jingyitang826/rfid-cocktail-bot/Input/Images/Input_Breadbord_Wiring.jpg

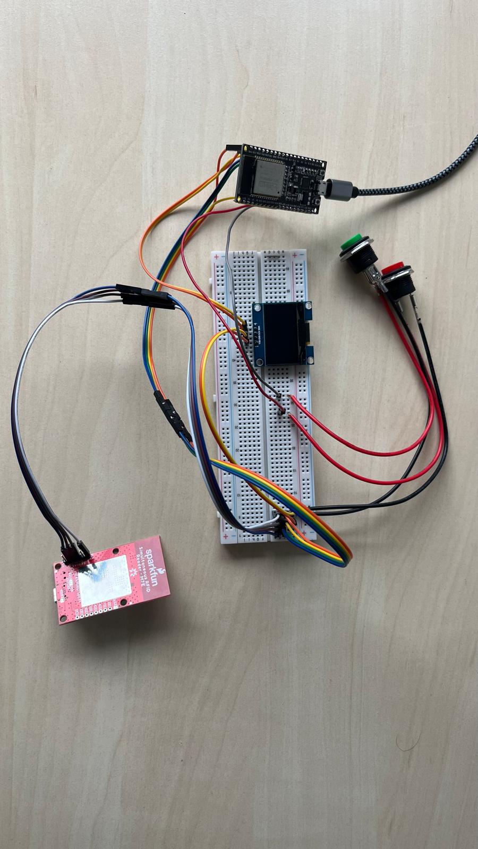
Input/Images/Input_Breadbord_Wiring.jpg
