jingyitang826/rfid-cocktail-bot/Input/Images/RFID_Wiring.jpg

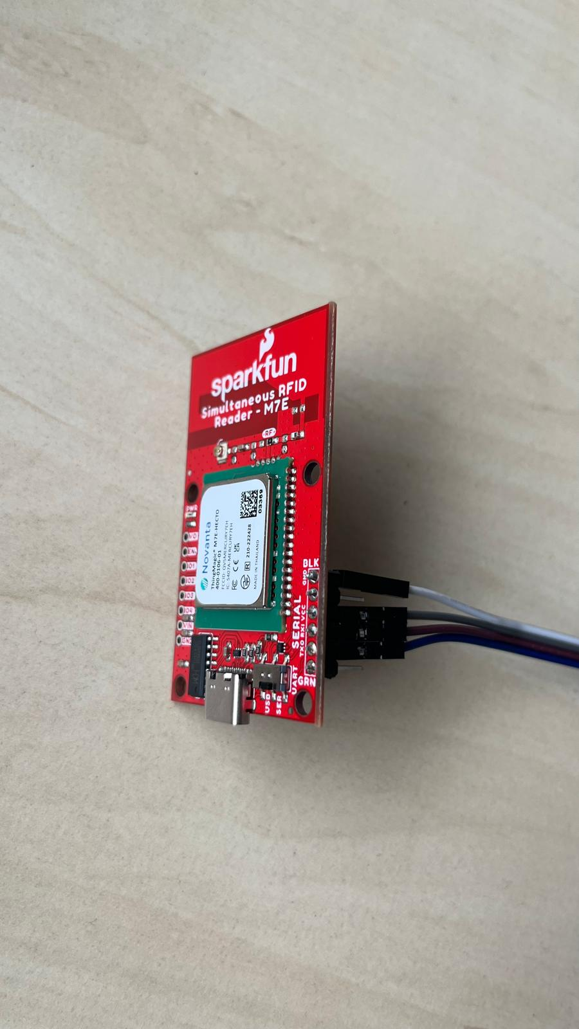
Input/Images/RFID_Wiring.jpg
