jingyitang826/rfid-cocktail-bot/Input/Images/Input.jpg

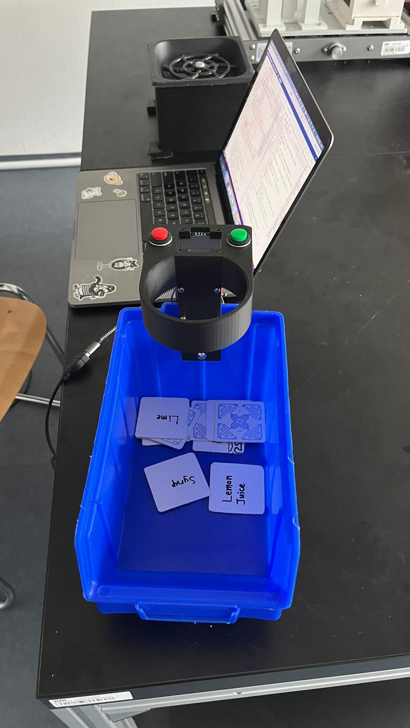
Input/Images/Input.jpg
