jingyitang826/rfid-cocktail-bot/Input/Images/Input_Back_View.jpg

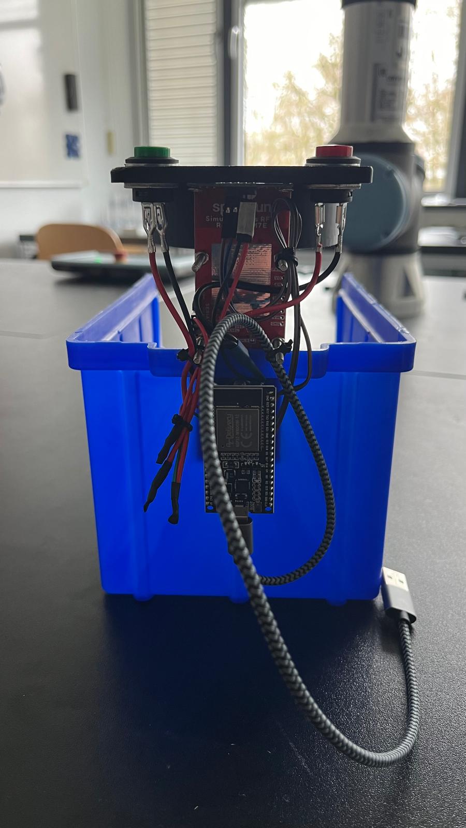
Input/Images/Input_Back_View.jpg
