jingyitang826/rfid-cocktail-bot/Input/Images/Input_Basket_Bottom.jpg

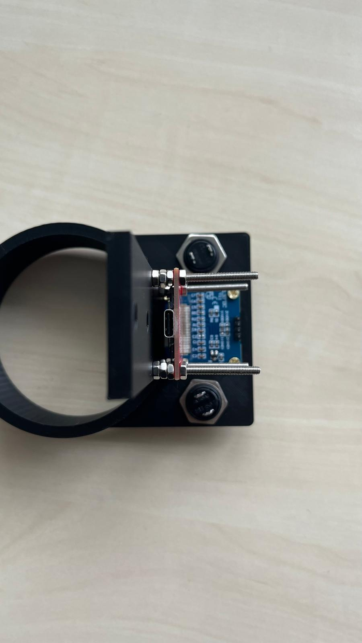
Input/Images/Input_Basket_Bottom.jpg
