jingyitang826/rfid-cocktail-bot/Input/Images/Input_Basket_Side.jpg

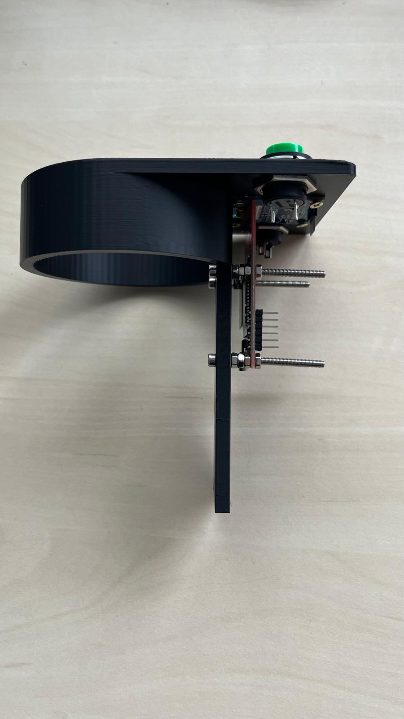
Input/Images/Input_Basket_Side.jpg
