jingyitang826/rfid-cocktail-bot/Input/Images/Input_Mount_1.jpg

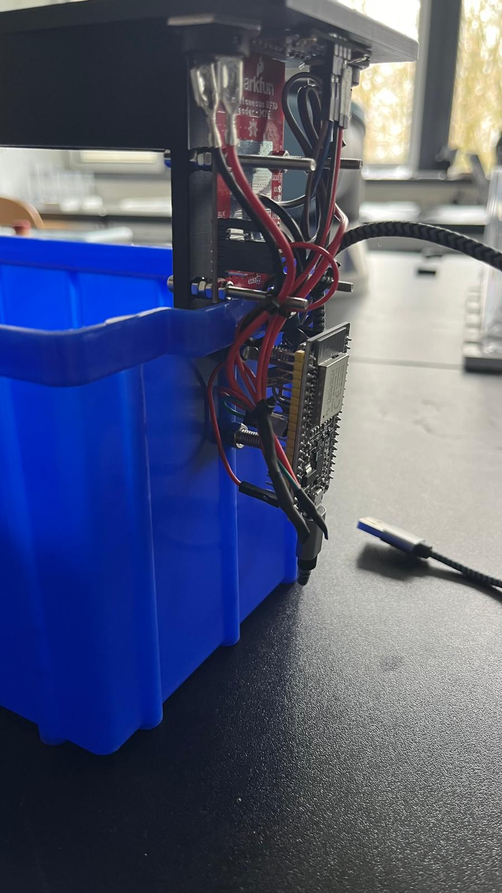
Input/Images/Input_Mount_1.jpg
