jingyitang826/rfid-cocktail-bot/Input/Images/Input_Mount_2.jpg

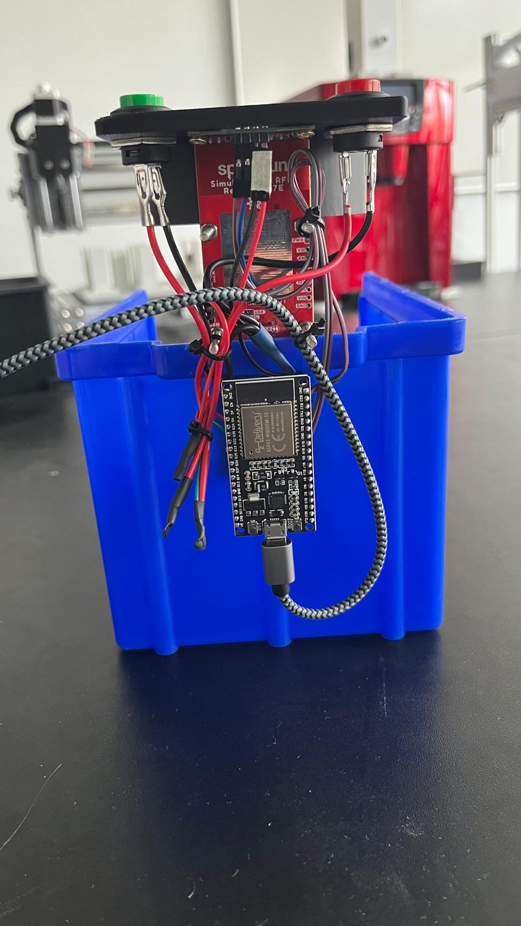
Input/Images/Input_Mount_2.jpg
