jingyitang826/rfid-cocktail-bot/Input/Images/Input_Mount_3.jpg

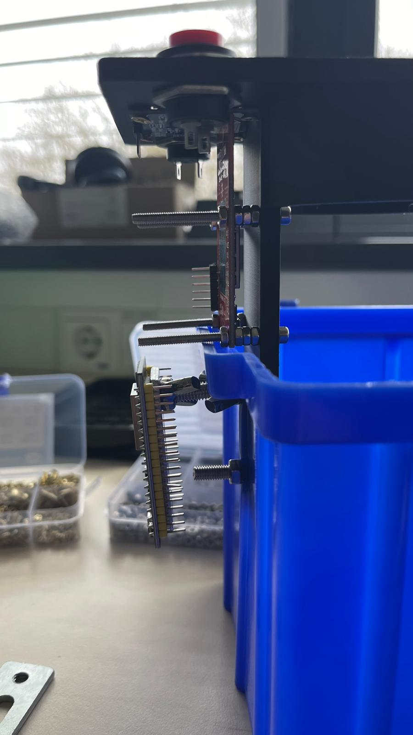
Input/Images/Input_Mount_3.jpg
