jingyitang826/rfid-cocktail-bot/Input/Images/Input_Mount_4.jpg

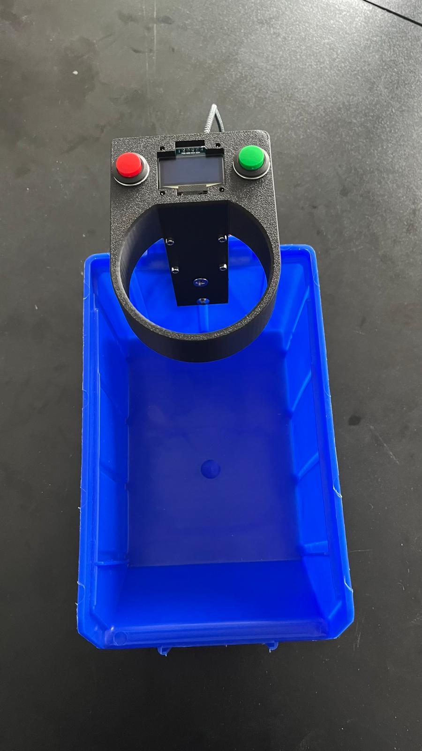
Input/Images/Input_Mount_4.jpg
