jingyitang826/rfid-cocktail-bot/Input/Images/Input_Mount_5.jpg

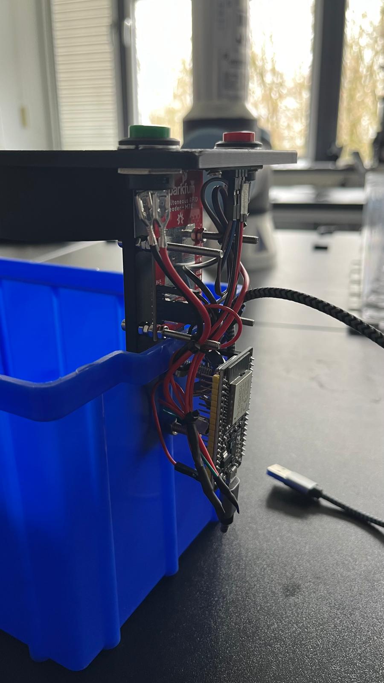
Input/Images/Input_Mount_5.jpg
