jingyitang826/rfid-cocktail-bot/Input/Images/Input_Top_View.jpg

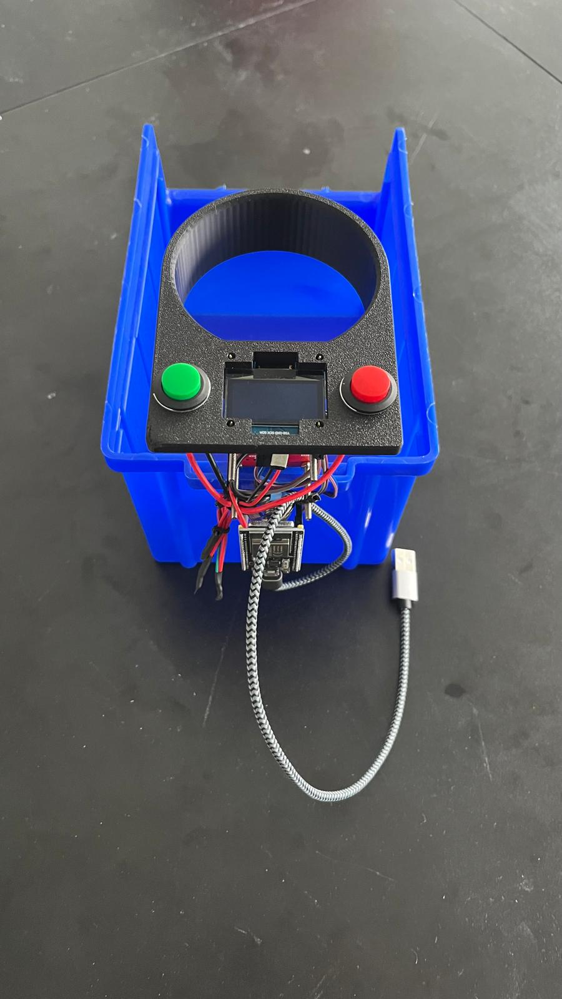
Input/Images/Input_Top_View.jpg
