jingyitang826/rfid-cocktail-bot/Input/Images/Input_with_RFID_Chips.jpg

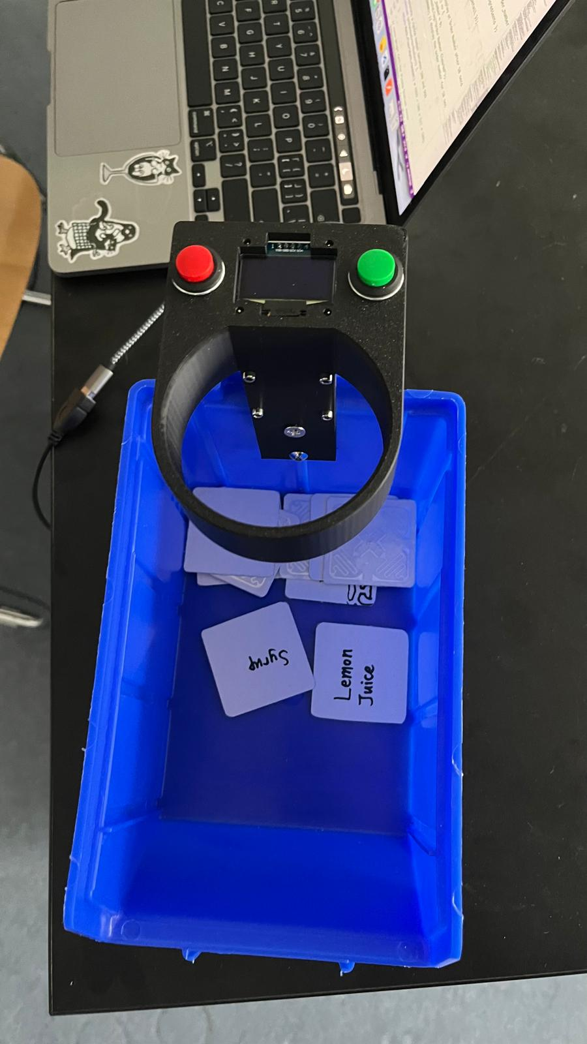
Input/Images/Input_with_RFID_Chips.jpg
