jingyitang826/rfid-cocktail-bot/Input/Images/RFID_and_ESP32_Mounted_2.jpg

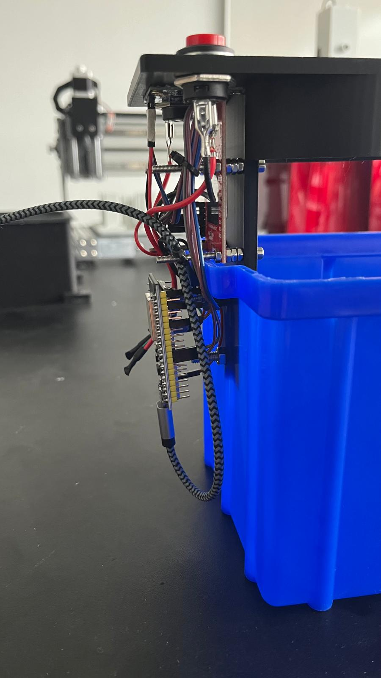
Input/Images/RFID_and_ESP32_Mounted_2.jpg
