jingyitang826/rfid-cocktail-bot/Videos/Cocktail_Robot.jpg

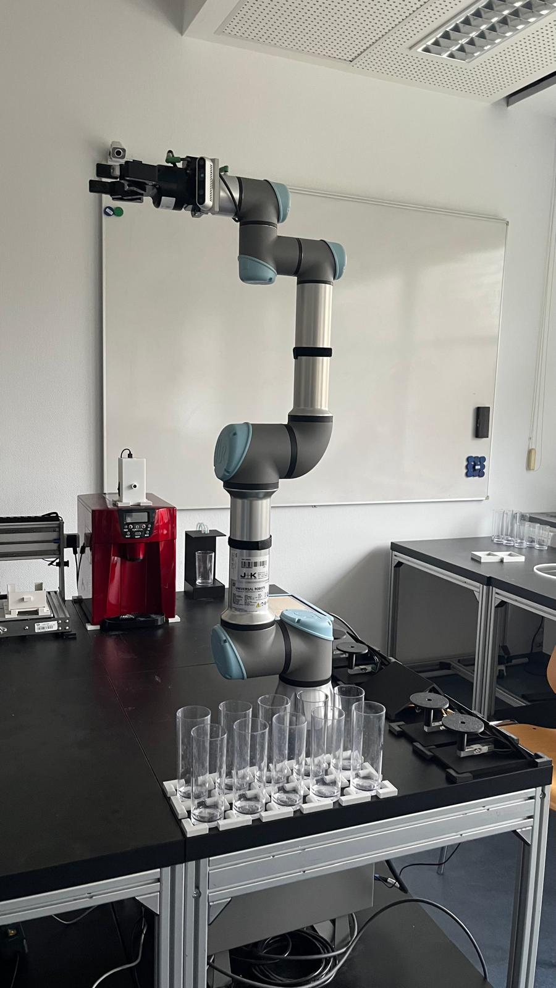
Videos/Cocktail_Robot.jpg
