jingyitang826/rfid-cocktail-bot/Input/Input_Basket.3mf

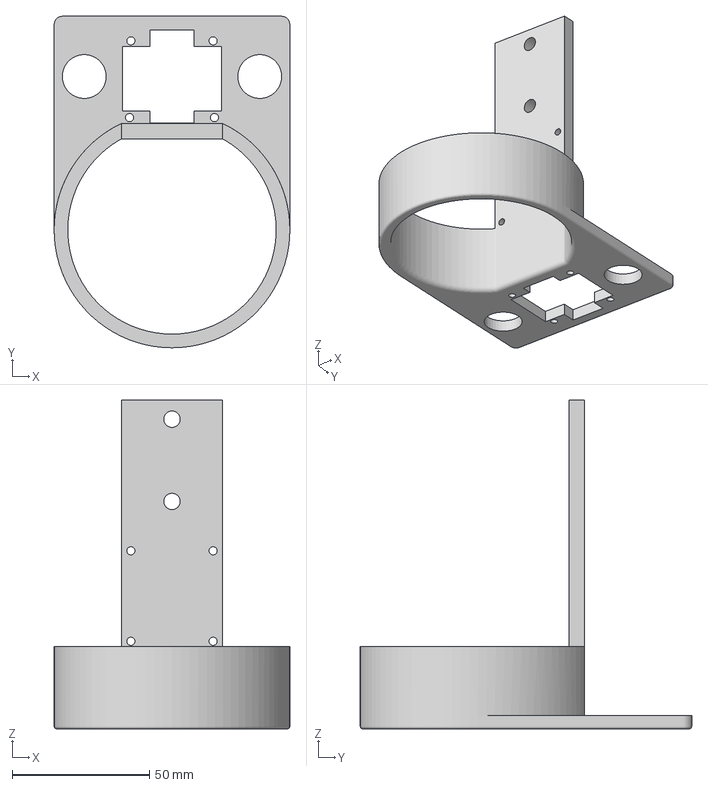
[picture p17: CAD file, 2025-04-29]
Input/Input_Basket.3mf
86.0 x 120.9 x 120.0 mm
