jingyitang826/rfid-cocktail-bot/Output/Output_Weight_Cell_Tray.stl

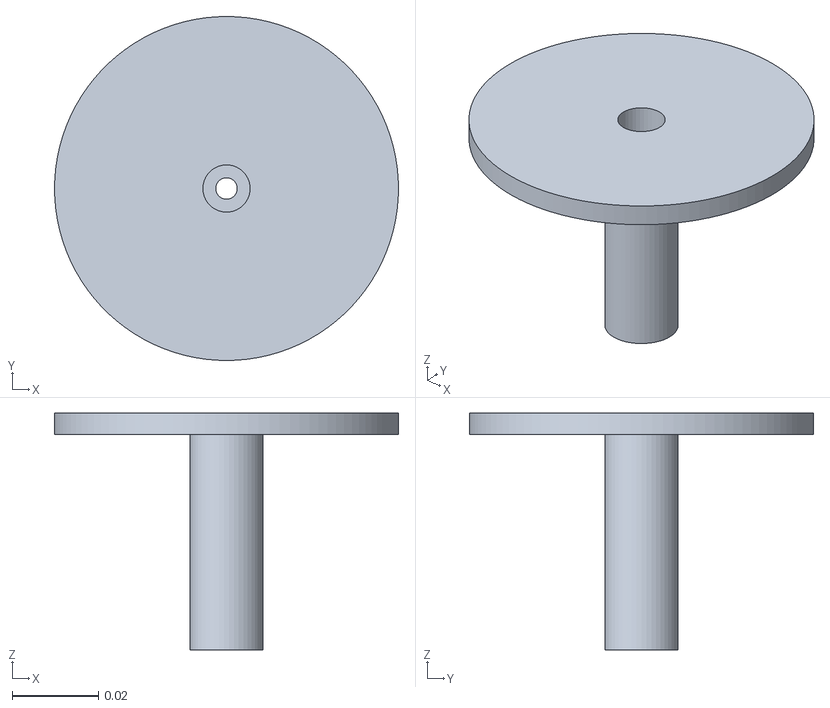
[picture p18: CAD file, 2025-04-30]
Output/Output_Weight_Cell_Tray.stl
0.08 x 0.08 x 0.055
