jingyitang826/rfid-cocktail-bot/Output/Output_Screen_Mount.3mf

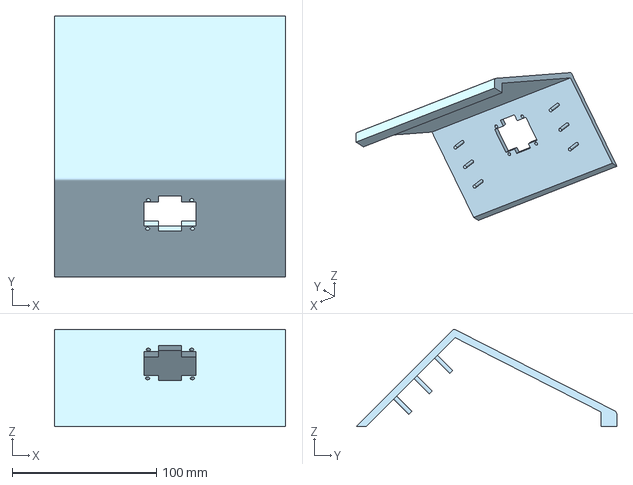
[picture p19: CAD file, 2025-04-30]
Output/Output_Screen_Mount.3mf
160.0 x 180.8 x 67.2 mm
