jingyitang826/rfid-cocktail-bot/Output/Output_Weight_Cell_Lower_Part.stl

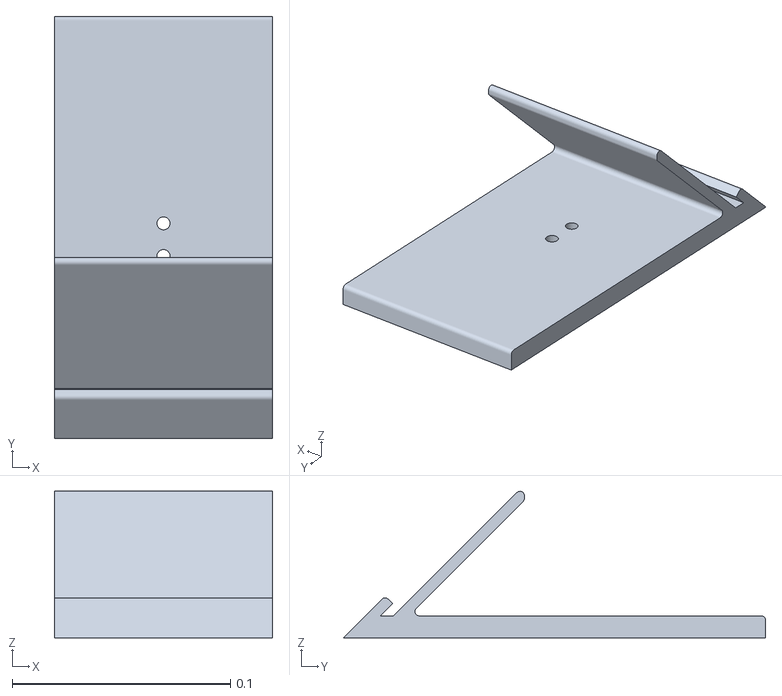
[picture p20: CAD file, 2025-04-30]
Output/Output_Weight_Cell_Lower_Part.stl
0.1 x 0.194 x 0.0672
