jingyitang826/rfid-cocktail-bot/Output/Output_Weight_Cell_Spacer.stl

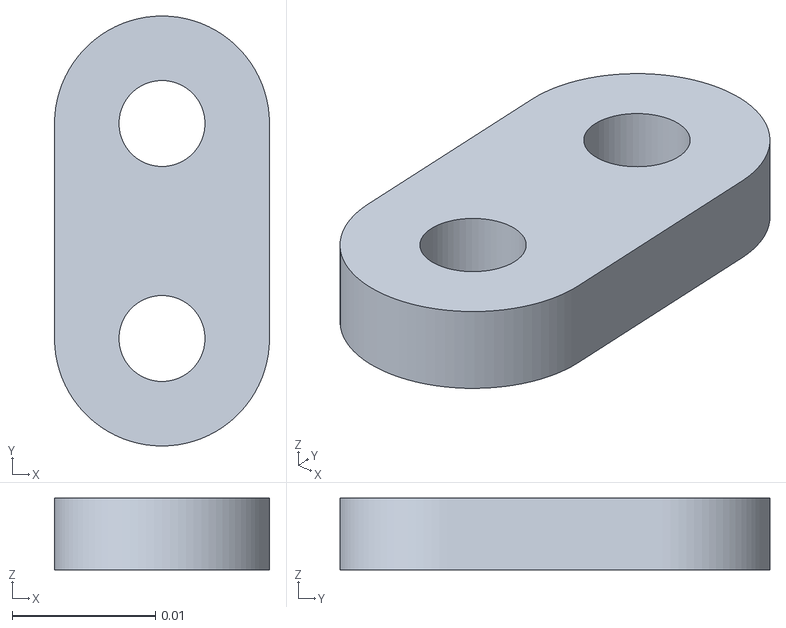
[picture p21: CAD file, 2025-04-30]
Output/Output_Weight_Cell_Spacer.stl
0.015 x 0.03 x 0.005
