jingyitang826/rfid-cocktail-bot/Input/Images/RFID_Assembly.jpg

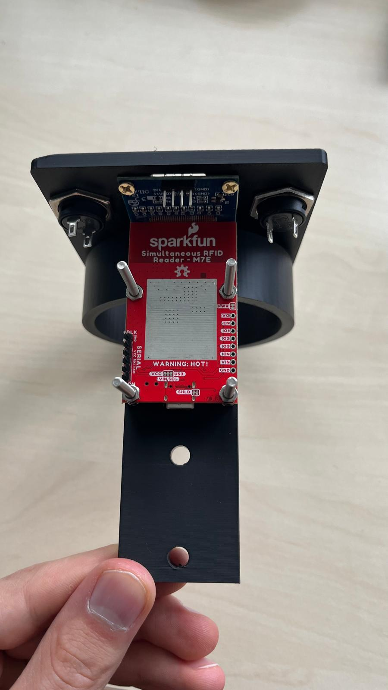
Input/Images/RFID_Assembly.jpg
