jingyitang826/rfid-cocktail-bot/Input/Images/RFID_Assembly_Side.jpg

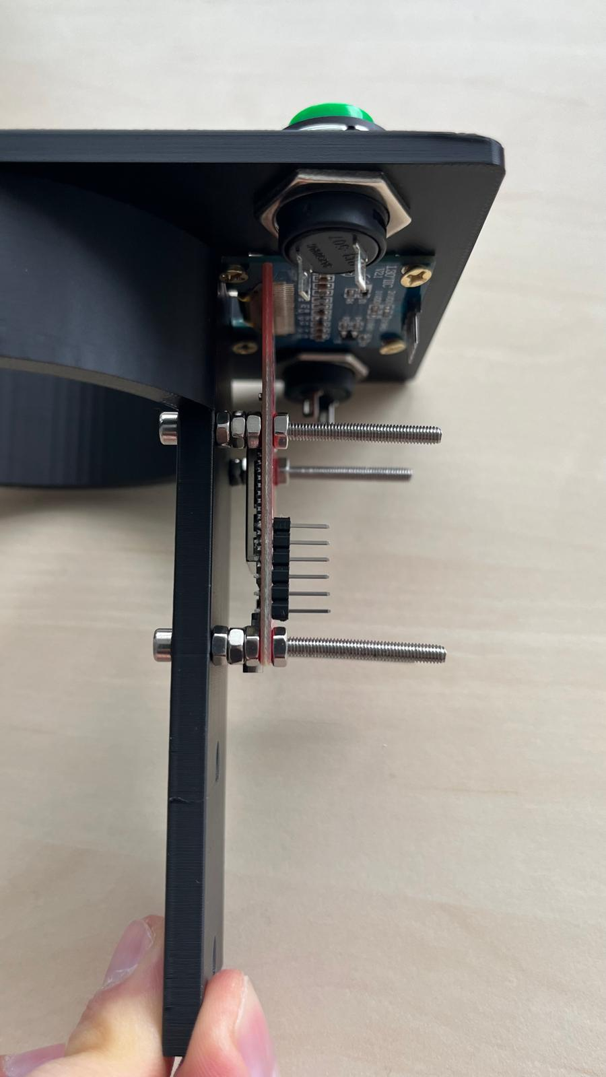
Input/Images/RFID_Assembly_Side.jpg
